venusjoel/JA-Achtung-Compact/README.md

# JA Achtung Compact — 1x1

This repository is the standalone one-tile version of our two-player
*Achtung, die Kurve!* hardware game for Tiny Tapeout. It uses cardinal
movement, a 1-bit external QSPI PSRAM framebuffer, and direct 640×480 VGA.

This is a complete ASIC design prepared for submission to Tiny Tapeout, where its verified SKY130 GDS layout is intended to be fabricated as part of a real shared silicon chip—not only run in simulation or on an FPGA.

## Gameplay demonstration

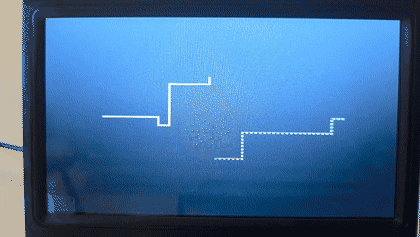
[picture p1: docs/images/gameplay.gif]
Real VGA demonstration of the JA Achtung Compact 1x1 monochrome game


*Authentic footage from the original project presentation: two players steer the Compact 1×1 design's cardinal-direction trails on a real VGA display.*

## Hardware at a glance

<p align="center">
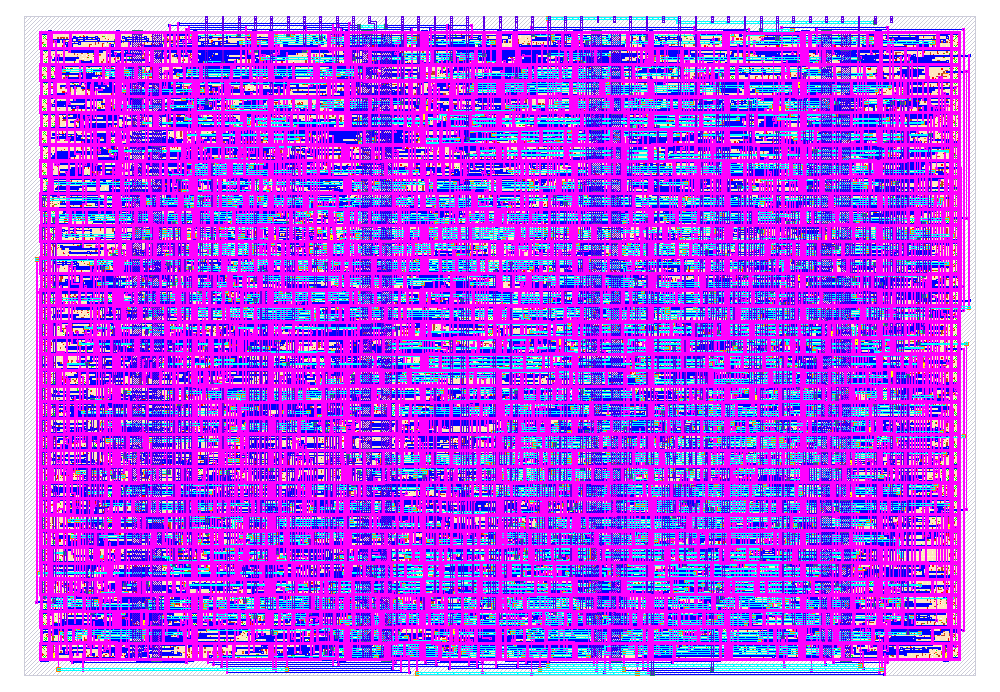
[picture p2: docs/images/gds-layout.png]
Final routed GDS layout of the JA Achtung Compact 1x1 Tiny Tapeout design
  
</p>

<p align="center">
  <em>Current main-branch SKY130 layout, rendered directly from the latest successful GDS workflow.</em><br>
  <a href="https://venusjoel.github.io/JA-Achtung-Compact/">Explore the interactive 3D GDS</a>
</p>

| Tiny Tapeout footprint | Standard-cell area | Final utilization | Physical signoff |
| :---: | ---: | ---: | :---: |
| 1×1 tile | 15,279.7 µm² | 92.6415% | 0 DRC/LVS/antenna violations |

## Project portfolio

The shared project materials cover both the Compact 1x1 and Full 1x2
implementations:

- [Presentation slides (PDF)](https://github.com/venusjoel/JA-Achtung-Full/blob/main/docs/portfolio/JA-Achtung-Project-Presentation.pdf)
- [Final project report (PDF)](https://github.com/venusjoel/JA-Achtung-Full/blob/main/docs/portfolio/JA-Achtung-Final-Report.pdf)
- [Download the PowerPoint with embedded demonstration videos](https://github.com/venusjoel/JA-Achtung-Full/raw/main/docs/portfolio/JA-Achtung-Project-Presentation.pptx)
- [Portfolio index and editable source files](https://github.com/venusjoel/JA-Achtung-Full/tree/main/docs/portfolio)

The Tiny Tapeout project is entirely at the repository root:

- `src/`: exact 1x1 HDL and LibreLane configuration
- `info.yaml`: 1x1 project metadata and pinout
- `docs/info.md`: datasheet source
- `test/`: root RTL and gate-level pin smoke tests
- `Game Simulation/tests/game_1x1/`: 1x1 VGA, game-model, and system tests
- `targets/1x1-minimal/`: byte-for-byte canonical mirror used by CI

## System architecture

<p align="center">
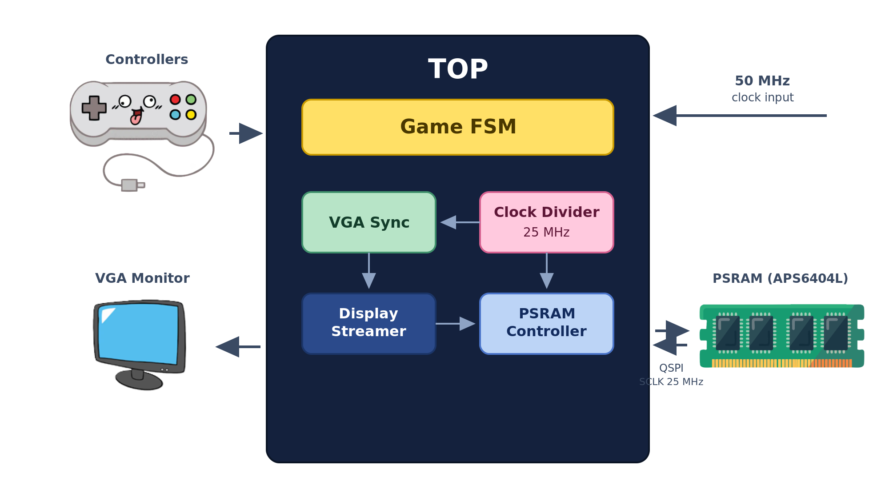
[picture p3: docs/images/system-architecture.png]
JA Achtung architecture showing the controllers, game FSM, VGA pipeline, clocking, and external QSPI PSRAM
  
</p>

Both versions stream the framebuffer through external QSPI PSRAM instead of
trying to store a full 640×480 frame in on-chip flip-flops. The Compact design
preserves the complete two-player VGA system in one tile by using cardinal
movement and a 1-bit framebuffer.

## Validation baseline

The exact HDL and configuration in this project were validated with LibreLane
3.0.3 and sky130A PDK revision `8afc8346`:

- standard-cell area: 15,279.7 µm²
- final utilization: 92.6415%
- worst setup slack: +5.22364 ns
- worst hold slack: +0.03444 ns
- worst-corner max-slew advisories: 174
- worst-corner max-capacitance advisories: 0
- worst-corner max-fanout advisories: 0
- setup, hold, routing DRC, Magic DRC, LVS, and antenna violations: 0
- Tiny Tapeout precheck: 15/15 passed
- powered gate-level QSPI/VGA smoke test: passed

The full 1x1 verification also covers a real 640×480 VGA frame, all 21 game
traces, collision semantics, gamepad input, QSPI traffic, and arbitration.

## Local tests

Run the one-time setup, then use the all-tests launcher whenever needed:

```sh
./setup-live
./test-all
```

`./test-all` runs the full-size and accelerated coarse game suites, the real
VGA/QSPI/system path, standalone PSRAM-controller and display-streamer tests,
the Tiny Tapeout top-level pin test, and the exhaustive compact gamepad-decoder
test, plus unit tests for the hardening-metric policy. It stops at the first
failure and prints a final success message only if every group passes.

The framebuffer is external. Hardware use requires a compatible QSPI PSRAM,
the Tiny Tapeout VGA PMOD, and the Gamepad PMOD. See `docs/info.md` for the
power-up sequence and pinout.

## Play it live

You can play the game yourself and have the hardware checked against your run.
Use an Ubuntu/WSL terminal in the repo root. The first time on each computer,
run the setup file (it installs/checks Icarus Verilog and creates an isolated,
pinned Python environment):

```sh
./setup-live
```

After that, no environment activation is needed:

```sh
./1x1 --live
```

A window opens, records your play, then replays the exact inputs through the
Verilog and diffs the hardware output against the Python model. Two players
share the keyboard: `A`/`D` steer player 1 and the left/right arrows steer
player 2; `Esc` or `Q` ends the recording. Add `--mode coarse` for a quick
low-resolution session.

`./1x1` without `--live` runs the full automatic test set. It also forwards every
other runner flag (`--test vga`, `--test suite`, `--gen`, …). These files are
developer conveniences only — no CI workflow uses them and they do not affect
the hardware, the Tiny Tapeout test harness, or GDS signoff.

## DE10-Lite FPGA

The [`fpga/`](fpga/) folder contains a reproducible Intel Quartus project that
builds and programs this exact `src/` RTL on a Terasic DE10-Lite. It also lists
the required VGA, QSPI PSRAM, and Gamepad PMOD wiring.
