venusjoel/JA-Achtung-Compact/Game Simulation/tests/common/tb_tt_um.v

`timescale 1ns/1ps

module tb_tt_um;
    reg        clk;
    reg        rst_n;
    reg        ena;
    reg  [7:0] ui_in;
    wire [7:0] uo_out;
    reg  [7:0] uio_in;
    wire [7:0] uio_out;
    wire [7:0] uio_oe;

    tt_um_ja_achtung_1x1 u_dut (
        .ui_in(ui_in),
        .uo_out(uo_out),
        .uio_in(uio_in),
        .uio_out(uio_out),
        .uio_oe(uio_oe),
        .ena(ena),
        .clk(clk),
        .rst_n(rst_n)
    );
endmodule
